GravesLab/rf-levelcontrol/analysis/plots/01 nano_vortex_10.csv.png

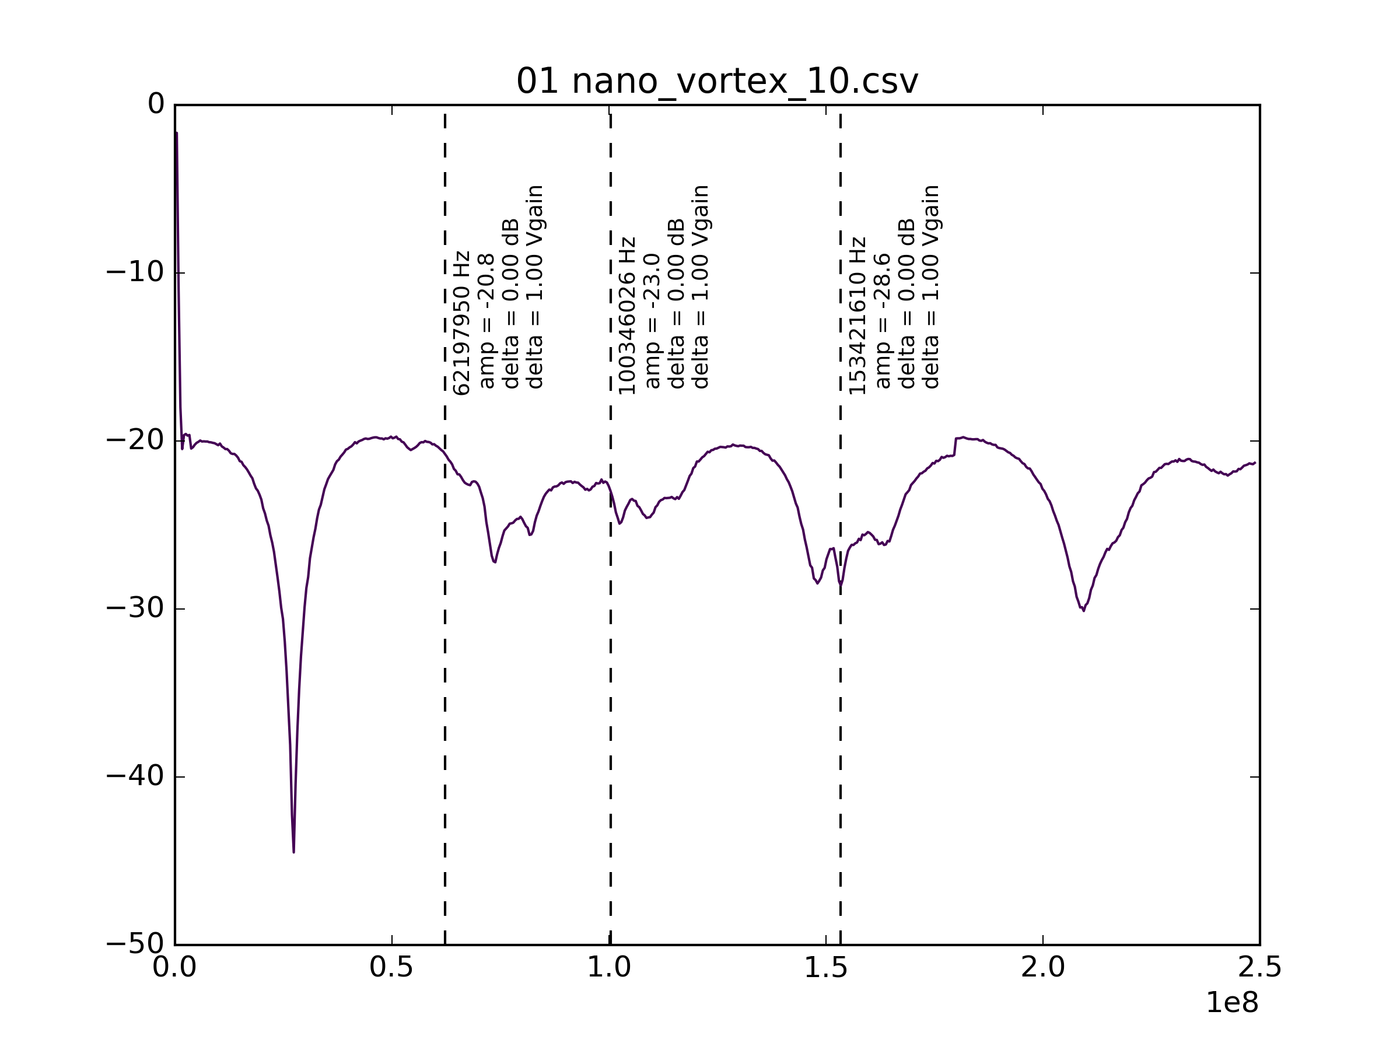
analysis/plots/01 nano_vortex_10.csv.png
