GravesLab/rf-levelcontrol/analysis/plots/02 nano_vortex_20.csv.png

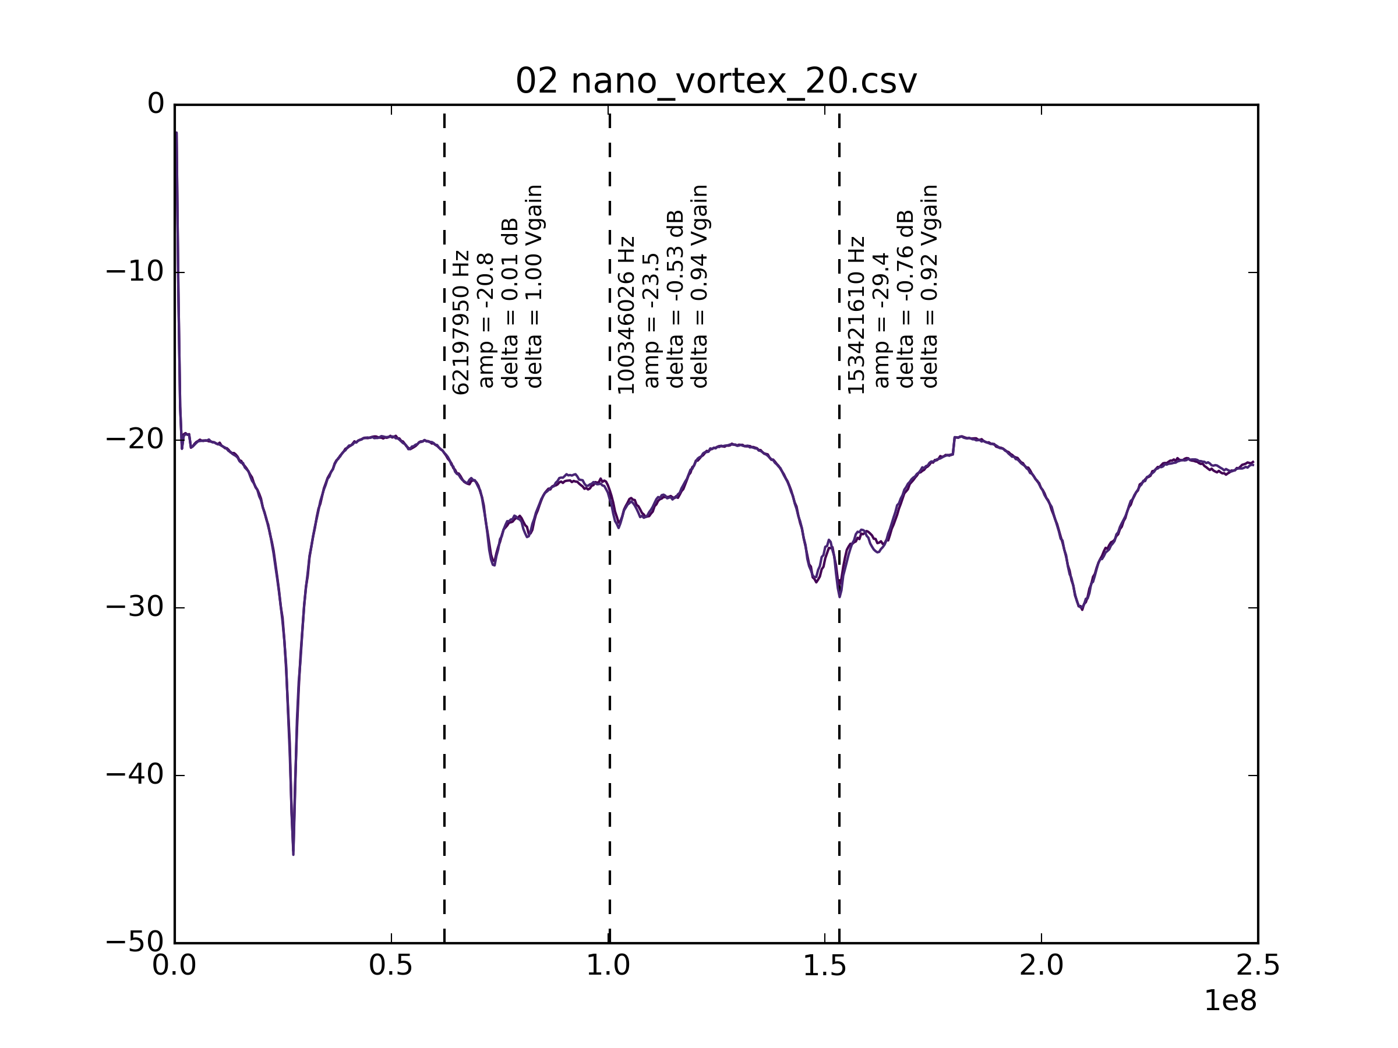
analysis/plots/02 nano_vortex_20.csv.png
