GravesLab/rf-levelcontrol/analysis/plots/09 nano_vortex_60.csv.png

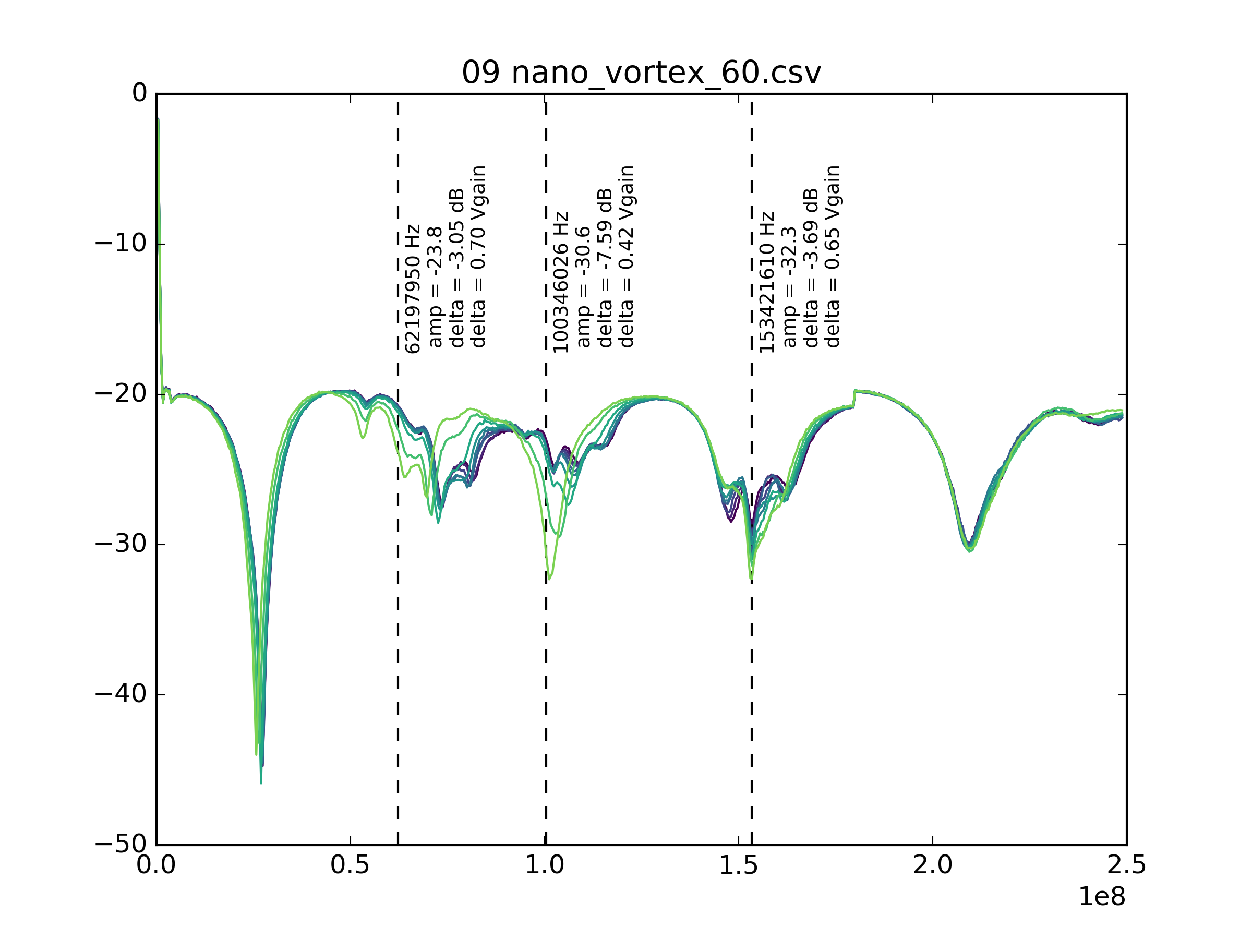
analysis/plots/09 nano_vortex_60.csv.png
