GravesLab/rf-levelcontrol/img/animated-nano.gif

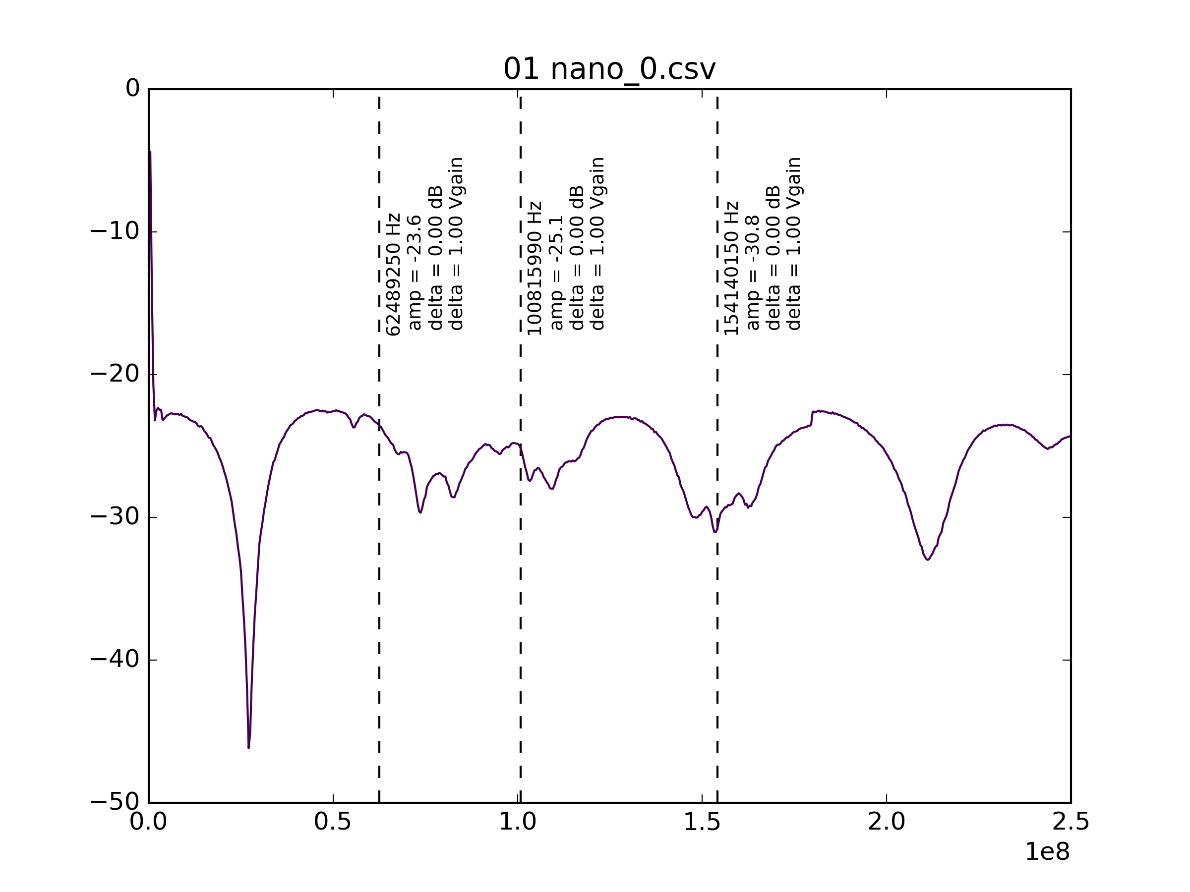
img/animated-nano.gif
