GravesLab/rf-levelcontrol/schematics/images/oscillator-schematic-bw.pdf

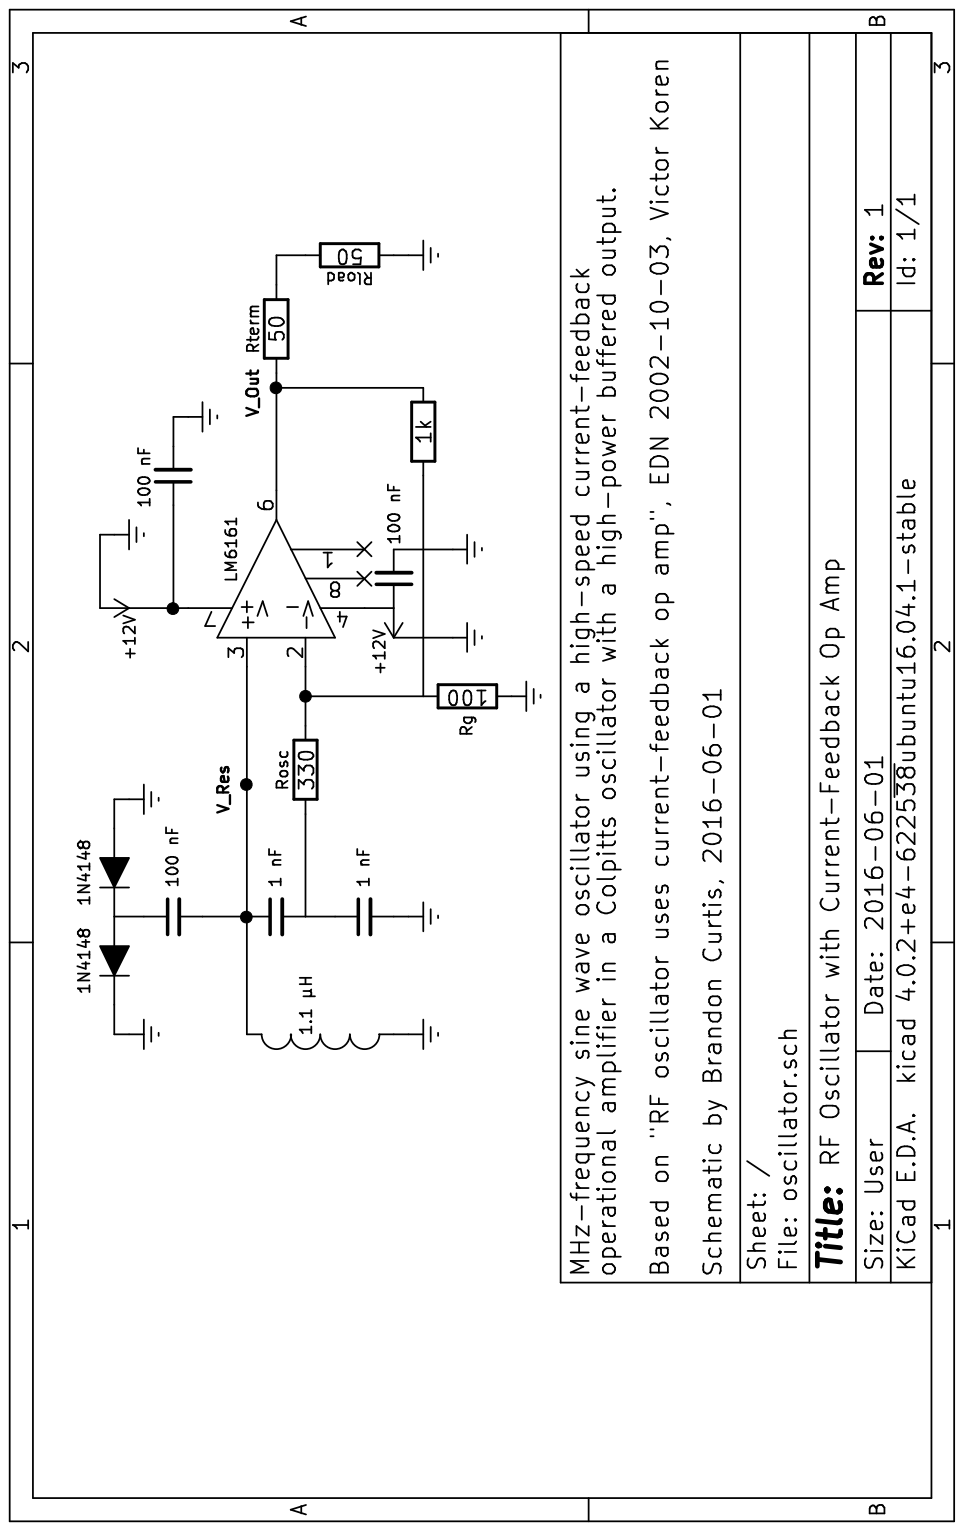
[picture p6: page 1]
