GravesLab/rf-levelcontrol/schematics/images/oscillator-schematic.pdf

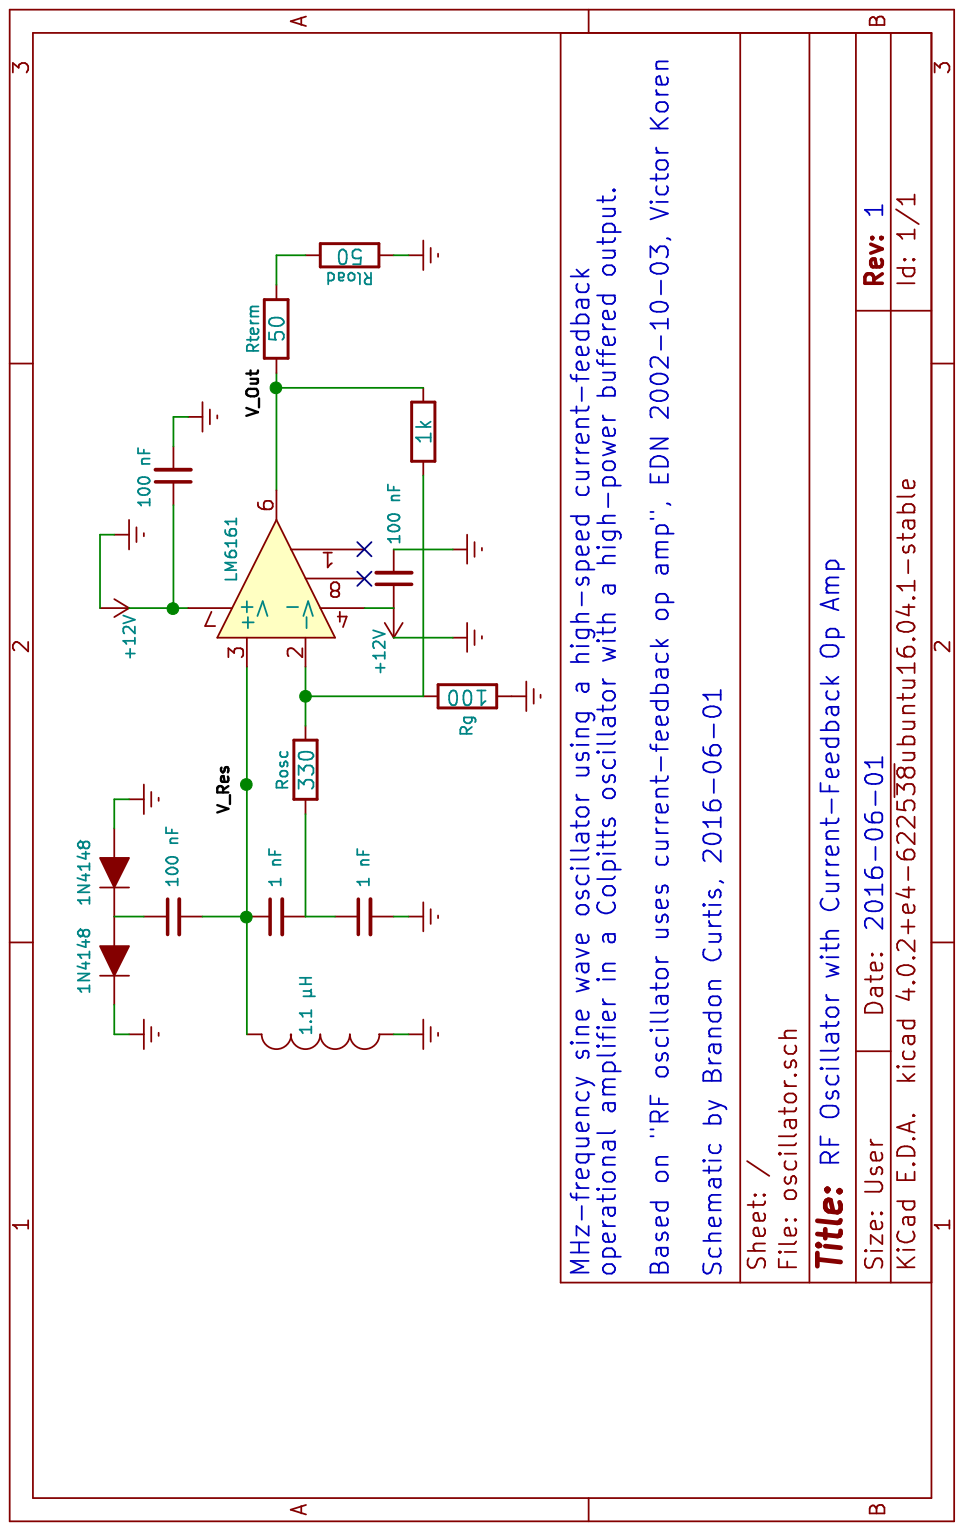
[picture p7: page 1]
