GravesLab/rf-levelcontrol/spice/colpitts_jfet.asc

C1: cap; 10p
C2: cap; 10p
J1: njf; U309
L1: ind; 330n
R1: res; 2.2k
R2: res; 0
V1: voltage; 10
Named nets: 0, OUT
.tran 50us startup
