GravesLab/rf-levelcontrol/spice/colpitts_jfet_model.asc

C1: cap; 10p
C2: cap; 10p
L1: ind; 10n
Q1: npn; 2N2222
R2: res; 1000.
V1: voltage; 10
Named nets: 0, Output
.tran 0 1us 0 0.01ns
