GravesLab/rf-levelcontrol/(commit log)

2016-06-16 added oscillator schematics
    [01 nano_0.csv, 01 nano_vortex_10.csv, 01 salt 0.csv, 01 salt vortex 10.csv, 02 nano_10.csv, 02 nano_vortex_20.csv, 02 salt 10.csv, 02 salt vortex 20.csv]
2016-06-16 fixed orientation of schematic used in README
2016-06-16 added experimental setup info from notes
    [oscillator.kicad_pcb, oscillator.sch]
